HydraulicRobert/arduinoPerso/Dateien/Fotos/LCD/nullPersonen.jpg

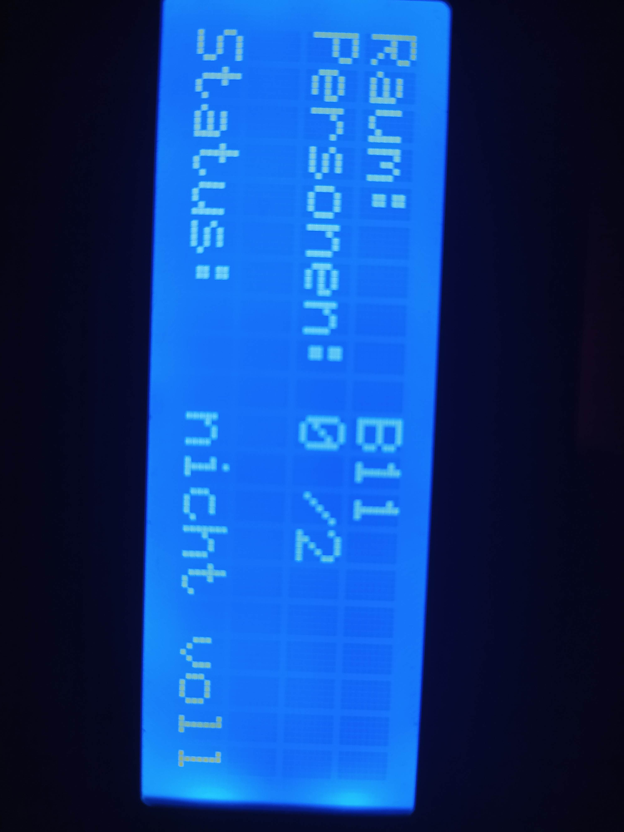
Dateien/Fotos/LCD/nullPersonen.jpg
