HydraulicRobert/arduinoPerso/Dateien/Rechnungen/LCD und Taster/rechnungAmazonLCD.PNG

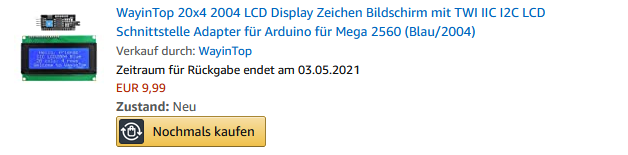
Dateien/Rechnungen/LCD und Taster/rechnungAmazonLCD.PNG
