HydraulicRobert/arduinoPerso/README.md

Arduino basierter Personenzähler. Zählt über Sensoren die vorbeigehenden Personen und speichert die rein- und rausgehenden Personen mitsamt der gerade im Raum befindlichen Personenzahl mit Zeitstempel
