HydraulicRobert/arduinoPerso/Präsentation/Präsentation Personenzähler.pptx

## Presentation about: People counter


By Rojat

## Slide 2

Contents

- Project
- What‘s a People Counter?
- How does it work?
- What if someone blocks it?
- What‘s infrared light?


- Why not another kind of sensor?
- Demonstration
- Summary
- Questions
- Imprint

## Slide 3

Project

- Project
- School time
- Technology lessons
- Part of
- Learning area 12.3


- Goal
- work
- Compromise
- Having a restricted budget
- Project documentation
- Learn Arduino


1/10

Notes: 2010 laut BFM

Nominallohnsteigerung – Preissteigerung = Reallohnsteigerung
Nettolohn = Nominallohn = Bruttolohn – Lohnabzüge

Kaufkraftverlust führt zur Nachfrageverringerung und dadurch Wohlstandsminderung

## Slide 4

What‘s a people counter?

- Click counter
- Mechanic
- Used to
- Count readings
- With a button

- Pressed by hand.
- It allows
- Multiple countings
- Used on
- Events
- Research


2/10

Notes: Zu den Personalzusatzkosten zählen alle Aufwendungen Der Arbeitgeber, welche für die Mitarbeiter neben dem reinen Arbeitsentgelt anfallen, auch als Lohnnebenkosten bezeichnet
Beispiel: max mustermann soll Techniker gehaltsvorstellung nennen. Am besten nicht zu hoch, da es im ausland viel günstiger möglich ist.

## Slide 5

How does it work?

- Sensors
- Infrared
- Detect motion
- Send signal
- to the arduino

- Arduino analyzes data
- Creates record
- On SD
- Outputs
- Amount of people
- On lcd


3/10

## Slide 6

What if someone blocks it?

- Outside
- Nothing happens
- Middle Sensor
- Output
- Third line

- „beweg dich“
- „move“
- Recorded
- Disappears
- No longer
- blocked


4/10

Notes: 2010 laut BFM

Nominallohnsteigerung – Preissteigerung = Reallohnsteigerung
Nettolohn = Nominallohn = Bruttolohn – Lohnabzüge

Kaufkraftverlust führt zur Nachfrageverringerung und dadurch Wohlstandsminderung

## Slide 7

What‘s infrared light?


- Physics
- Electromagnetic radiaton
- Sinus wave
- Heat
- Sun

- Great for skin
- Too much
- Unheatlhy
- cancer


5/10

Notes: 2010 laut BFM

Nominallohnsteigerung – Preissteigerung = Reallohnsteigerung
Nettolohn = Nominallohn = Bruttolohn – Lohnabzüge

Kaufkraftverlust führt zur Nachfrageverringerung und dadurch Wohlstandsminderung

## Slide 8

Why not another kind of sensor?

- PIR
- Passive infrared
- Cooldown
- Not Realtime
- Didnt work

- Buttons
- Press
- Noone
- Corona

6/10

Notes: 2010 laut BFM

Nominallohnsteigerung – Preissteigerung = Reallohnsteigerung
Nettolohn = Nominallohn = Bruttolohn – Lohnabzüge

Kaufkraftverlust führt zur Nachfrageverringerung und dadurch Wohlstandsminderung

## Slide 9

Demonstration

- Test
- Count
- Up
- State
- Down

- Check
- Excel
- Diagram
- Show


7/10

Notes: 2010 laut BFM

Nominallohnsteigerung – Preissteigerung = Reallohnsteigerung
Nettolohn = Nominallohn = Bruttolohn – Lohnabzüge

Kaufkraftverlust führt zur Nachfrageverringerung und dadurch Wohlstandsminderung

## Slide 10

Summary

- Project
- School
- Technology
- Part of Learning area 12.3
- People counter
- Arduino


- Sensors
- LCD
- Infrared
- Cancer
- Mine doesnt


8/10

Notes: 2010 laut BFM

Nominallohnsteigerung – Preissteigerung = Reallohnsteigerung
Nettolohn = Nominallohn = Bruttolohn – Lohnabzüge

Kaufkraftverlust führt zur Nachfrageverringerung und dadurch Wohlstandsminderung

## Slide 11

Questions

Any questions?


If(fragen==0){
next();
};


9/10

Notes: 2010 laut BFM

Nominallohnsteigerung – Preissteigerung = Reallohnsteigerung
Nettolohn = Nominallohn = Bruttolohn – Lohnabzüge

Kaufkraftverlust führt zur Nachfrageverringerung und dadurch Wohlstandsminderung

## Slide 12

Imprint

https://www.bfs.de/DE/themen/opt/ir/einfuehrung/einfuehrung_node.html
https://de.wikipedia.org/wiki/Handz%C3%A4hler
https://de.wikipedia.org/wiki/Strahlung
https://de.wikipedia.org/wiki/Mechanik

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

10/10

Notes: 2010 laut BFM

Nominallohnsteigerung – Preissteigerung = Reallohnsteigerung
Nettolohn = Nominallohn = Bruttolohn – Lohnabzüge

Kaufkraftverlust führt zur Nachfrageverringerung und dadurch Wohlstandsminderung
