HydraulicRobert/arduinoPerso/Dateien/Deckblatt/Deckblatt.docx

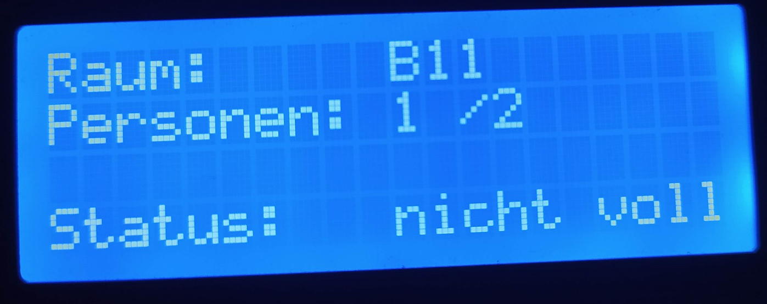
[picture p73: figure]

Projektmappe

Arduino Personenzähler

Rojat Kadah FOST 19

Arduino basierter Personenzähler BBS Verden
