HydraulicRobert/arduinoPerso/Dateien/Sonstiges/quellenangaben.docx

Trct 5000 fritzing
https://forum.fritzing.org/t/ky-033-line-tracing-sensor/1406

LCD fritzing
https://forum.fritzing.org/t/20x4-lcd-display-with-integrated-i2c-based-on-lcd1602-i2c-by-stephen-lilley/6814/7

Arduino Datenblatt
http://ww1.microchip.com/downloads/en/DeviceDoc/Atmel-7810-Automotive-Microcontrollers-ATmega328P_Datasheet.pdf

TRCT 5000 Datenblatt
https://cdn.shopify.com/s/files/1/1509/1638/files/Tracker_Sensor_TCRT5000_Linienfolger_Modul_Datenblatt.pdf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

LCD Datenblatt
https://cdn.shopify.com/s/files/1/1509/1638/files/HD44780_2004_Blaues_LCD_Display_Datenblatt_AZ-Delivery_Vertriebs_GmbH_dbc38321-88f1-4a4c-95da-0babb44c755f.pdf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

Bibliothek SD.h
https://www.arduino.cc/reference/en/libraries/sd/

Bibliothek SPI.h
In der IDE integriert. #include <SPI.h> reicht für die Verwendung aus
https://www.arduino.cc/en/reference/SPI

Bibliothek wire.h
In der IDE integriert. #include <Wire.h> reicht für die Verwendung aus
https://www.arduino.cc/en/reference/wire

Bibliothek liquidcrystal_i2c.h
https://www.arduino.cc/reference/en/libraries/liquidcrystal-i2c/

int
https://www.computerlexikon.com/was-ist-integer

float
https://de.wikipedia.org/wiki/Gleitkommazahl

string
https://de.wikipedia.org/wiki/Zeichenkette

char
https://de.wikipedia.org/wiki/Char_(Datentyp)

file
https://www.arduino.cc/en/Reference/SDopen

void
https://de.wikipedia.org/wiki/Void_(Schl%C3%BCsselwort)
