HydraulicRobert/arduinoPerso/Dateien/Datenblätter/SD Modul/SPI Reader Micro Speicherkartenmodul Arduino Schematics.pdf

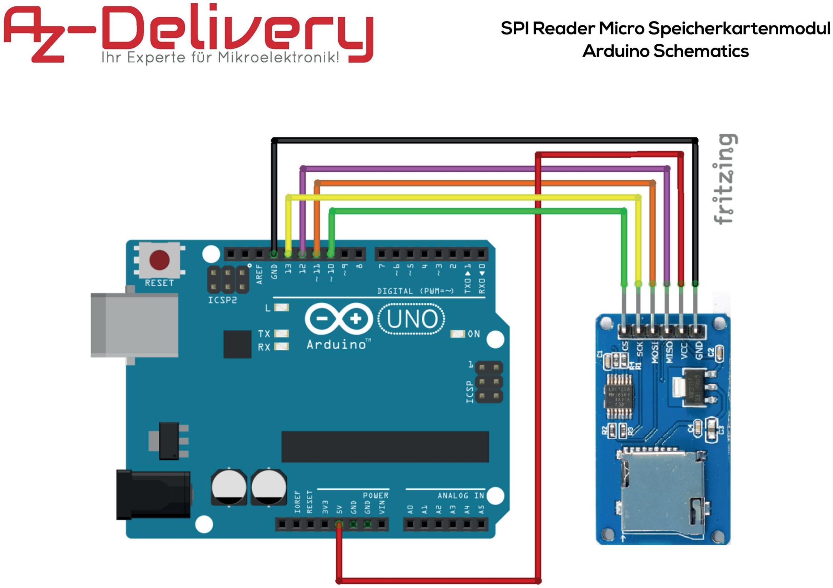
[picture p141: page 1]
