HydraulicRobert/arduinoPerso/Dateien/Datenblätter/SD Modul/SPI Reader Micro Speicherkartenmodul Pinout.pdf

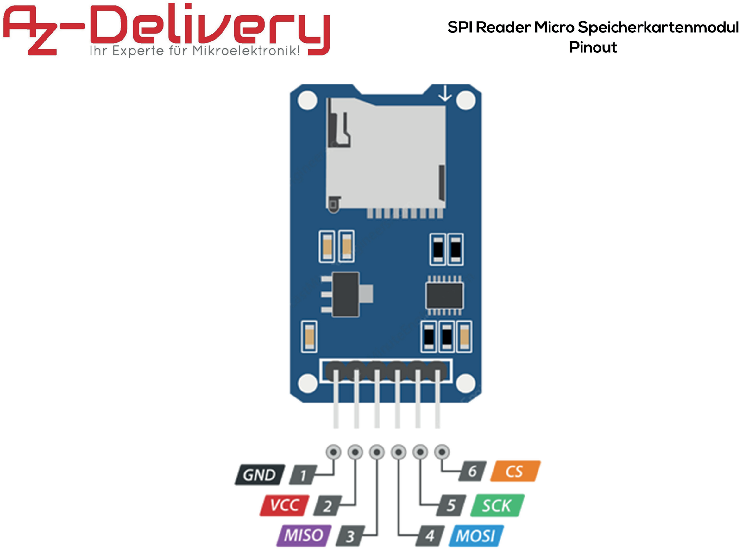
[picture p142: page 1]
