HydraulicRobert/arduinoPerso/Dateien/Fotos/LCD/einePerson.jpg

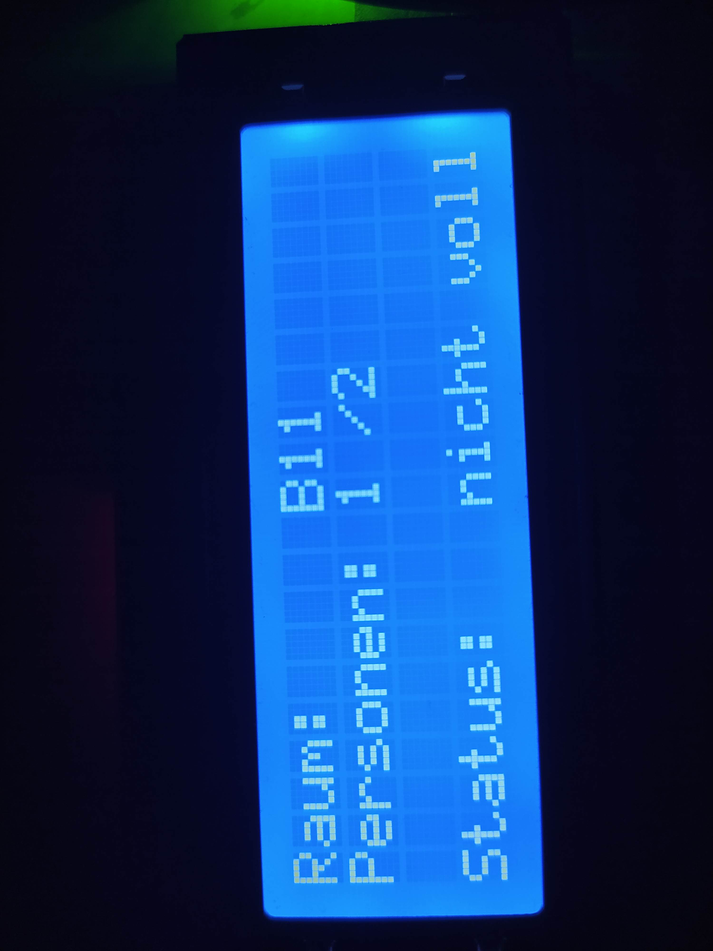
Dateien/Fotos/LCD/einePerson.jpg
