HydraulicRobert/arduinoPerso/Dateien/Fotos/LCD/fuenfPersonen.jpg

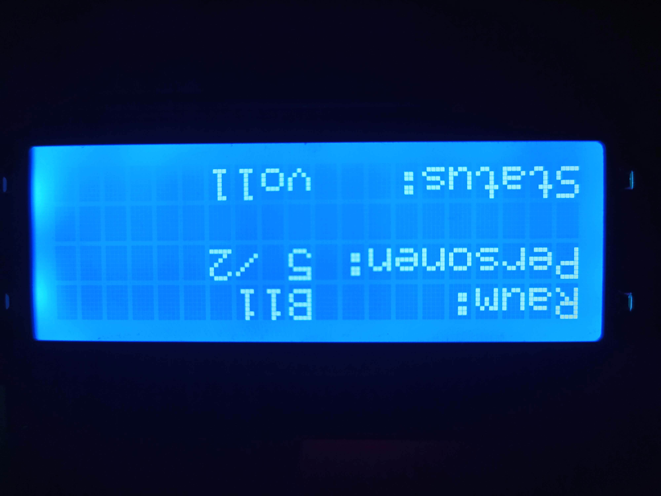
Dateien/Fotos/LCD/fuenfPersonen.jpg
