HydraulicRobert/arduinoPerso/Dateien/Fotos/LCD/sd fail.jpg

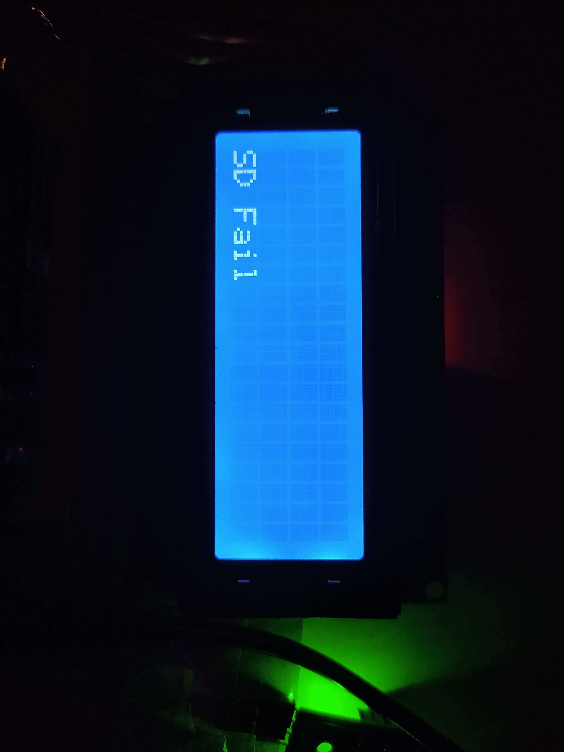
Dateien/Fotos/LCD/sd fail.jpg
