HydraulicRobert/arduinoPerso/Dateien/Fotos/LCD/Titelbild.jpg

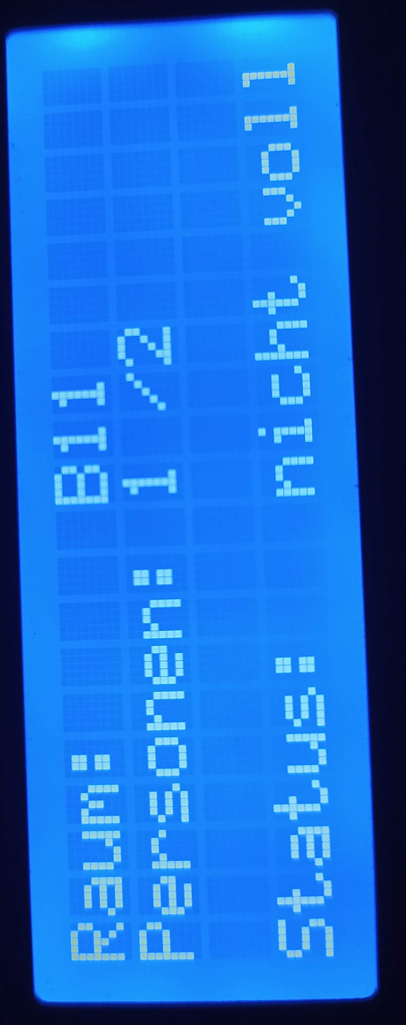
Dateien/Fotos/LCD/Titelbild.jpg
