HydraulicRobert/arduinoPerso/Dateien/Fotos/LCD/zweiPersonen.jpg

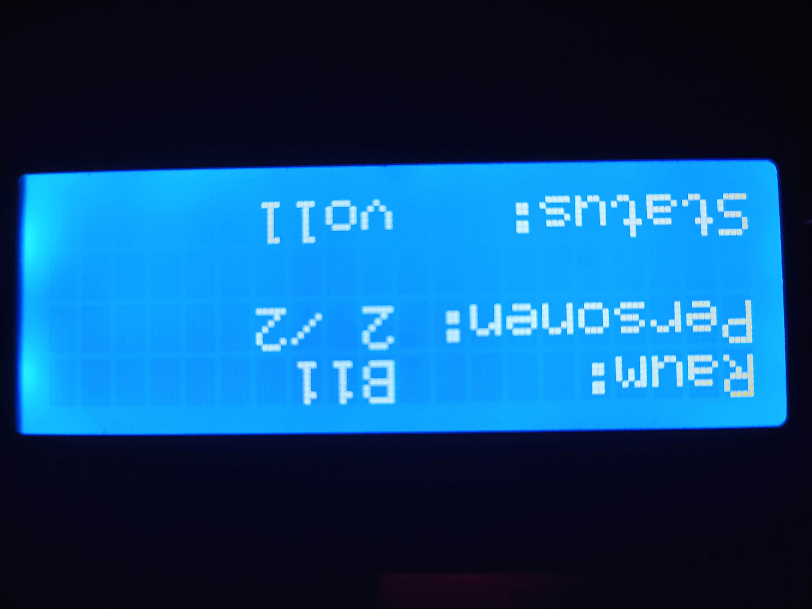
Dateien/Fotos/LCD/zweiPersonen.jpg
