HydraulicRobert/arduinoPerso/Dateien/Rechnungen/Arduino Uno/rechnungAmazonArduinoUno.PNG

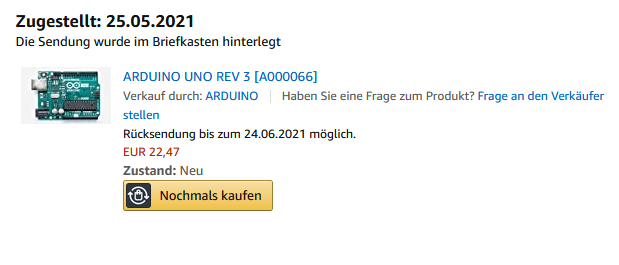
Dateien/Rechnungen/Arduino Uno/rechnungAmazonArduinoUno.PNG
