HydraulicRobert/arduinoPerso/Dateien/Rechnungen/Lesezeichen/rechnungAmazonLesezeichen.PNG

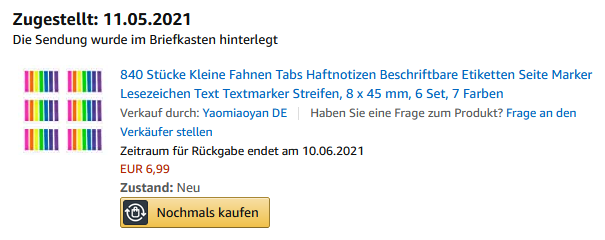
Dateien/Rechnungen/Lesezeichen/rechnungAmazonLesezeichen.PNG
