HydraulicRobert/arduinoPerso/Dateien/Rechnungen/Lötkolben/rechnungAmazonLötkolben.PNG

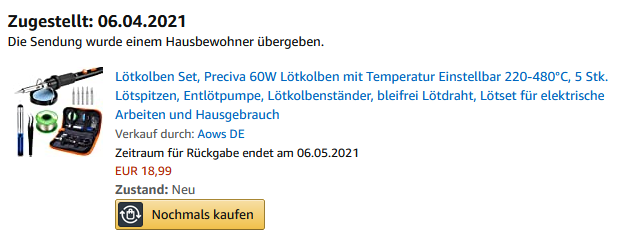
Dateien/Rechnungen/Lötkolben/rechnungAmazonLötkolben.PNG
