HydraulicRobert/arduinoPerso/Dateien/Rechnungen/PIR/rechnungAmazonPIR.PNG

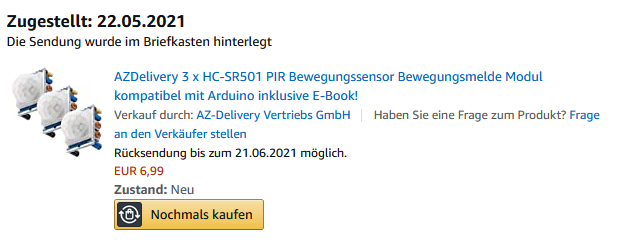
Dateien/Rechnungen/PIR/rechnungAmazonPIR.PNG
