HydraulicRobert/arduinoPerso/Dateien/Struktogramm/struktogrammVoll.png

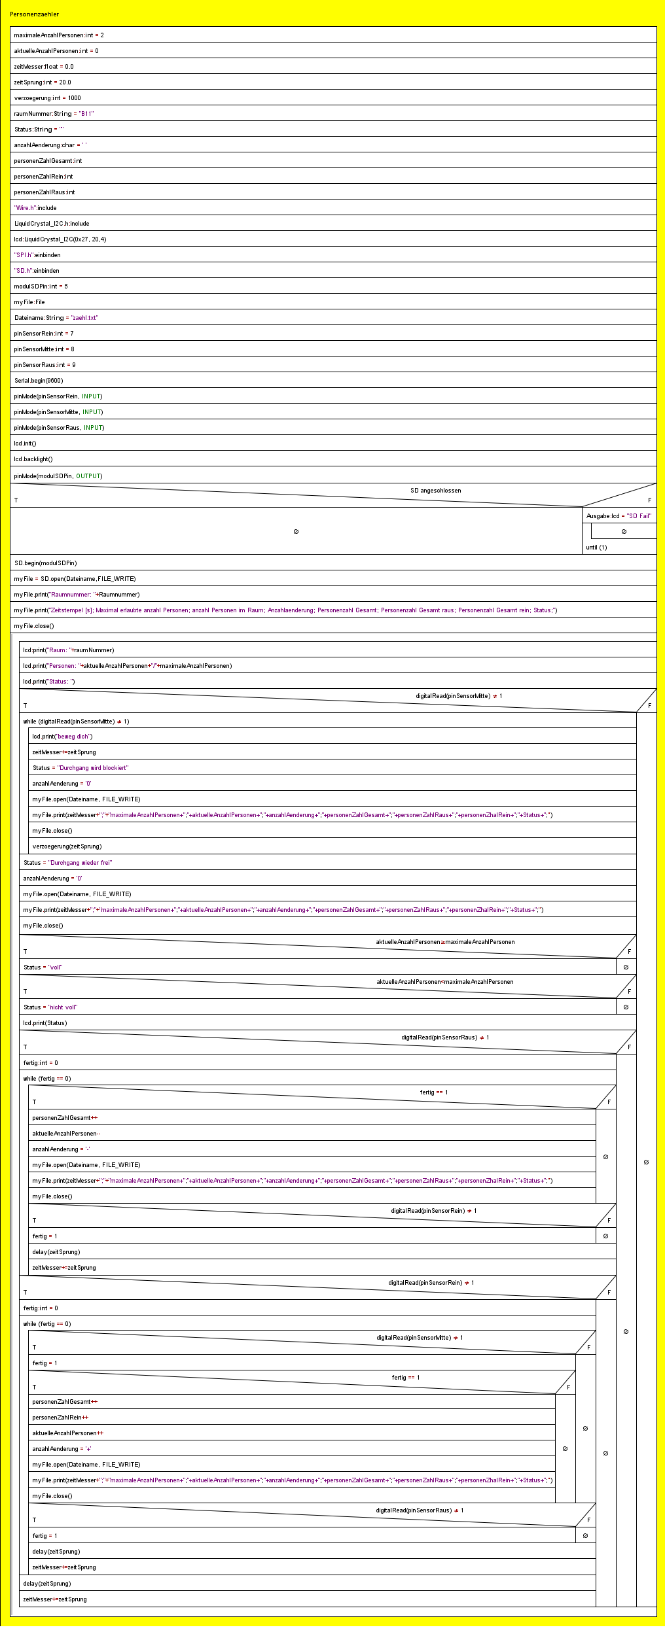
Dateien/Struktogramm/struktogrammVoll.png
