HydraulicRobert/arduinoPerso/Präsentation/300px-Orientierte_Fläche.png

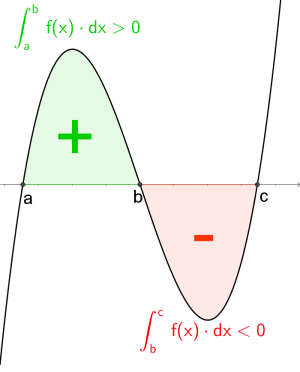
Präsentation/300px-Orientierte_Fläche.png
