HydraulicRobert/arduinoPerso/Dateien/Rechnungen/Rechnung.xlsx

Komponente | Anzahl | Einzelpreis | Gesamtpreis
Arduino Uno Revision 3 | 2 | 22,47€ | 22,47€+80€
Jumperkabel 20cm | 2 Packungen | 7,99€ | 15,98€
 | a 40 Kabel
KY-004 Taster | 1 Packung | 5,99€ | 5,99€
 | a 3 Taster
20x4 Zeichen 2004 LCD-Display | 2 | 9,99€ | 19,98€
Lesezeichen Sticker | 1 Packung | 6,99€ | 6,99€
 | a 840 Sticker
Lötkolben 60W | 1 | 18,99€ | 18,99€
Netzteil 9V 2A | 1 | 11,49€ | 11,49€
32GB Micro SD | 1 | 4,79€ | 4,79€
Micro SD Shield | 1 | 5,29€ | 5,29€
TRCT 5000 | 2 Packungen | 4,99€ | 9,98€
 | a 3 Sensoren
Gesamt |  | 98,98€ | 277,96 €
