HydraulicRobert/arduinoPerso/Dateien/Testdurchlauf/Durchgang blockiert/Tabelle.csv

Raumnummer: | B11
Zeitstempel [s] | Maximal erlaubte anzahl Personen | anzahl Personen im Raum | Anzahlaenderung | Personenzahl Gesamt | Personenzahl Gesamt raus | Personenzahl Gesamt rein | Status
0.32 | 2 | 0 | 0 | 0 | 0 | 0 | Durchgang wird blockiert
0.34 | 2 | 0 | 0 | 0 | 0 | 0 | Durchgang wird blockiert
0.36 | 2 | 0 | 0 | 0 | 0 | 0 | Durchgang wird blockiert
0.38 | 2 | 0 | 0 | 0 | 0 | 0 | Durchgang wird blockiert
0.4 | 2 | 0 | 0 | 0 | 0 | 0 | Durchgang wird blockiert
0.42 | 2 | 0 | 0 | 0 | 0 | 0 | Durchgang wird blockiert
0.44 | 2 | 0 | 0 | 0 | 0 | 0 | Durchgang wird blockiert
0.46 | 2 | 0 | 0 | 0 | 0 | 0 | Durchgang wird blockiert
0.48 | 2 | 0 | 0 | 0 | 0 | 0 | Durchgang wird blockiert
0.5 | 2 | 0 | 0 | 0 | 0 | 0 | Durchgang wird blockiert
0.52 | 2 | 0 | 0 | 0 | 0 | 0 | Durchgang wird blockiert
0.54 | 2 | 0 | 0 | 0 | 0 | 0 | Durchgang wird blockiert
0.56 | 2 | 0 | 0 | 0 | 0 | 0 | Durchgang wird blockiert
0.58 | 2 | 0 | 0 | 0 | 0 | 0 | Durchgang wird blockiert
0.6 | 2 | 0 | 0 | 0 | 0 | 0 | Durchgang wird blockiert
0.62 | 2 | 0 | 0 | 0 | 0 | 0 | Durchgang wird blockiert
0.64 | 2 | 0 | 0 | 0 | 0 | 0 | Durchgang wird blockiert
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
