HydraulicRobert/arduinoPerso/Dateien/Testdurchlauf/Durchgang blockiert/Tabelle.xlsx

Raumnummer: | B11
Zeitstempel [s] | Maximal erlaubte anzahl Personen | anzahl Personen im Raum | Anzahlaenderung | Personenzahl Gesamt | Personenzahl Gesamt raus | Personenzahl Gesamt rein | Status
1.64 | 2 | 0 | 0 | 0 | 0 | 0 | Durchgang wird blockiert
1.66 | 2 | 0 | 0 | 0 | 0 | 0 | Durchgang wird blockiert
1.68 | 2 | 0 | 0 | 0 | 0 | 0 | Durchgang wird blockiert
1.7 | 2 | 0 | 0 | 0 | 0 | 0 | Durchgang wird blockiert
1.72 | 2 | 0 | 0 | 0 | 0 | 0 | Durchgang wird blockiert
1.72 | 2 | 0 | 0 | 0 | 0 | 0 | Durchgang wieder frei
