HydraulicRobert/arduinoPerso/Dateien/Testdurchlauf/maximum erreicht/Tabelle.xlsx

Raumnummer: | B11
Zeitstempel [s] | Maximal erlaubte anzahl Personen | anzahl Personen im Raum | Anzahlaenderung | Personenzahl Gesamt | Personenzahl Gesamt raus | Personenzahl Gesamt rein | Status
0.92 | 2 | 0 | 0 | 0 | 0 | 0 | Durchgang wird blockiert
0.92 | 2 | 0 | 0 | 0 | 0 | 0 | Durchgang wieder frei
1.24 | 2 | 1 | + | 1 | 0 | 1 | nicht voll
1.3 | 2 | 1 | 0 | 1 | 0 | 1 | Durchgang wird blockiert
1.3 | 2 | 1 | 0 | 1 | 0 | 1 | Durchgang wieder frei
2.48 | 2 | 2 | + | 2 | 0 | 2 | nicht voll
2.54 | 2 | 2 | 0 | 2 | 0 | 2 | Durchgang wird blockiert
2.56 | 2 | 2 | 0 | 2 | 0 | 2 | Durchgang wird blockiert
2.58 | 2 | 2 | 0 | 2 | 0 | 2 | Durchgang wird blockiert
2.6 | 2 | 2 | 0 | 2 | 0 | 2 | Durchgang wird blockiert
2.6 | 2 | 2 | 0 | 2 | 0 | 2 | Durchgang wieder frei
2.84 | 2 | 3 | + | 3 | 0 | 3 | voll
2.9 | 2 | 3 | 0 | 3 | 0 | 3 | Durchgang wird blockiert
2.92 | 2 | 3 | 0 | 3 | 0 | 3 | Durchgang wird blockiert
2.94 | 2 | 3 | 0 | 3 | 0 | 3 | Durchgang wird blockiert
2.96 | 2 | 3 | 0 | 3 | 0 | 3 | Durchgang wird blockiert
2.96 | 2 | 3 | 0 | 3 | 0 | 3 | Durchgang wieder frei
3.2 | 2 | 4 | + | 4 | 0 | 4 | voll
4.66 | 2 | 5 | + | 5 | 0 | 5 | voll
6.58 | 2 | 4 | - | 6 | 1 | 5 | voll
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
