HydraulicRobert/arduinoPerso/Dateien/Testdurchlauf/maximum erreicht/Diagramm Maximum Gesamt.PNG

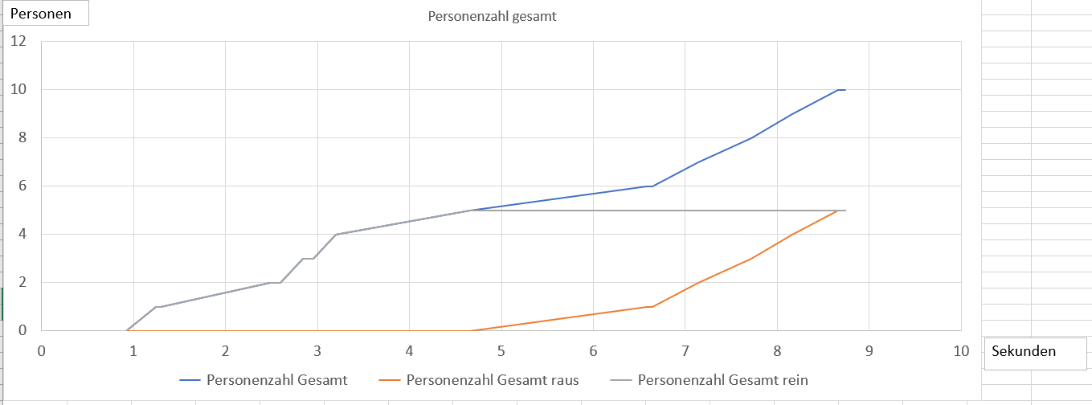
Dateien/Testdurchlauf/maximum erreicht/Diagramm Maximum Gesamt.PNG
