HydraulicRobert/arduinoPerso/(list of files, drawings)

Other design files:
Dateien/skizze/Steckplatine.fzz
